danielljeon/component_library/model_3d/time_of_flight/VL53L3 MODULE ASSEMBLY.step

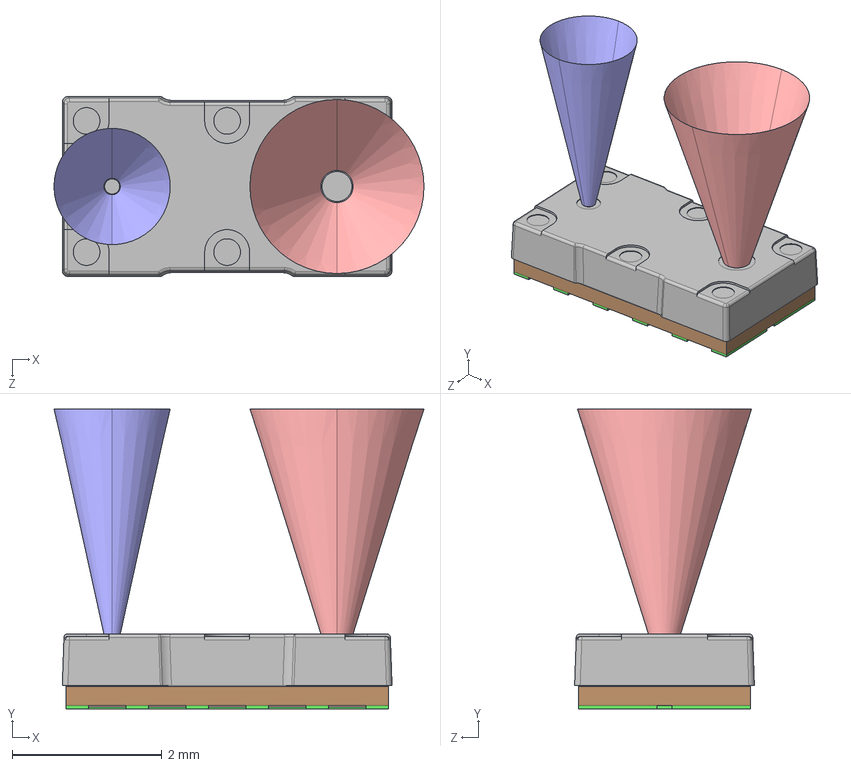
[picture p1: CAD file, 2025-02-09]
model_3d/time_of_flight/VL53L3 MODULE ASSEMBLY.step
4.94 x 4.00 x 2.40 mm
VL53L3 Substrate
VL53L3 Cap
VL53L3 Tx Exclusion Cone
VL53L3 Rx Exclusion Cone
