danielljeon/component_library/model_3d/0_standard/SOT-23-5.step

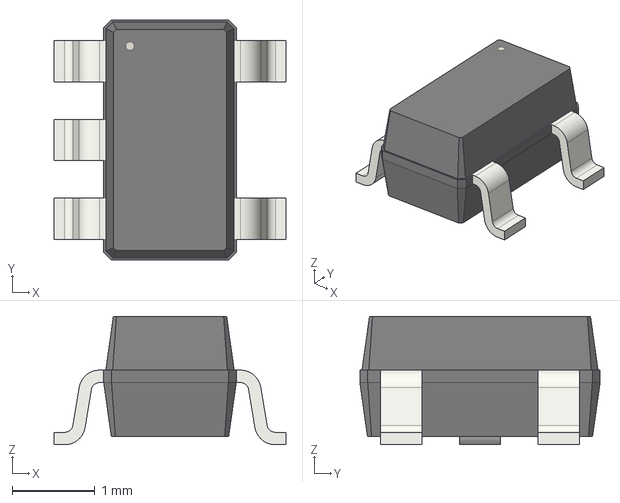
[picture p2: CAD file, 2025-07-11]
model_3d/0_standard/SOT-23-5.step
2.80 x 2.90 x 1.55 mm
