danielljeon/component_library/model_3d/bosch/BMP581.step

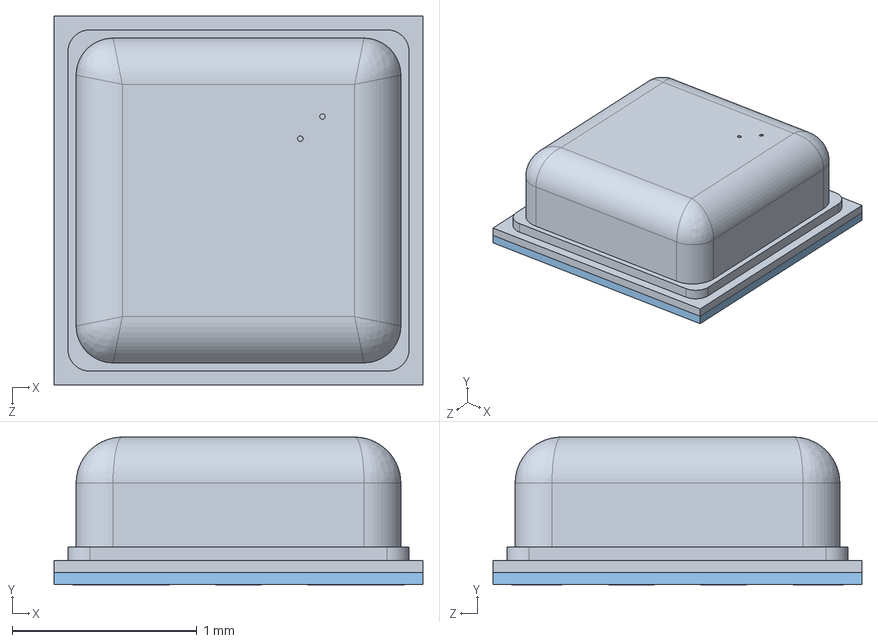
[picture p4: CAD file, 2024-11-15]
model_3d/bosch/BMP581.step
2.00 x 0.801 x 2.00 mm
