danielljeon/component_library/model_3d/ceva/BNO085.stp

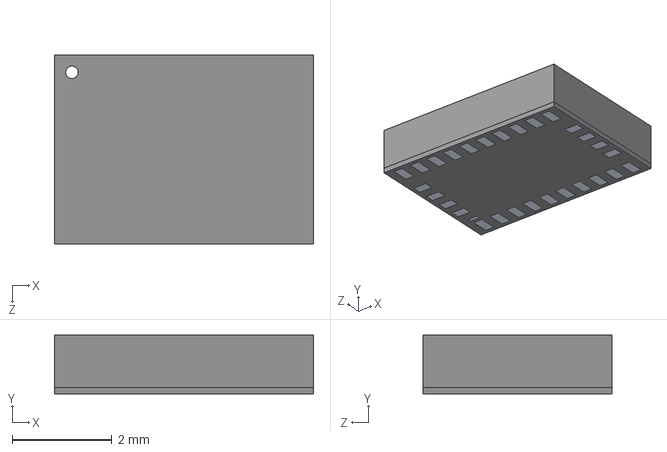
[picture p5: CAD file, 2024-11-15]
model_3d/ceva/BNO085.stp
5.20 x 1.18 x 3.80 mm
