danielljeon/component_library/model_3d/common/ecs_ecx-53r.STEP

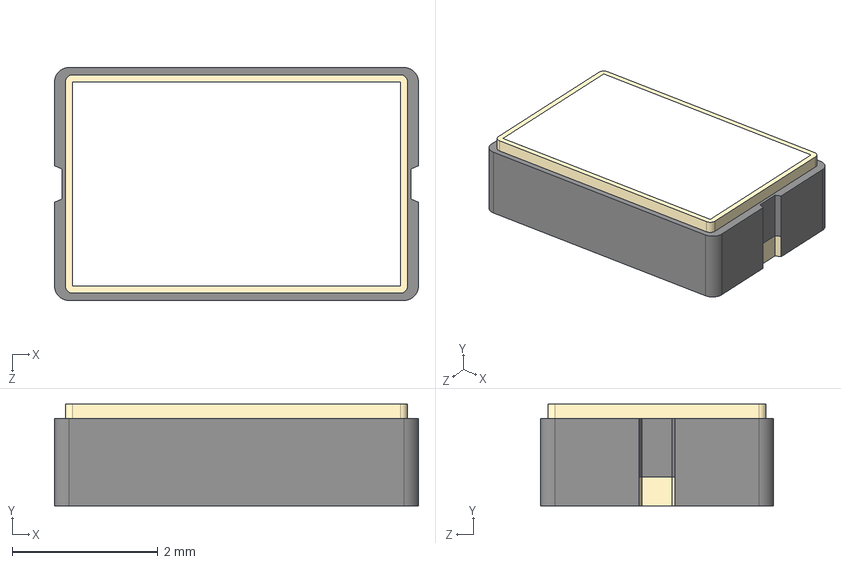
[picture p6: CAD file, 2026-04-29]
model_3d/common/ecs_ecx-53r.STEP
5.00 x 1.40 x 3.20 mm
