danielljeon/component_library/model_3d/digi_xbee/c-1-2314876-0-a-3d.stp

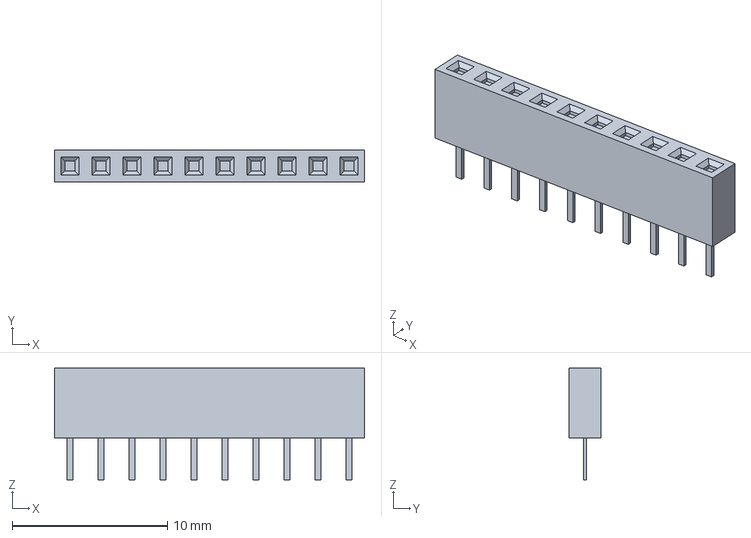
[picture p7: CAD file, 2024-11-12]
model_3d/digi_xbee/c-1-2314876-0-a-3d.stp
20.0 x 2.06 x 7.20 mm
