danielljeon/component_library/model_3d/inductors/SRN6045TA.STEP

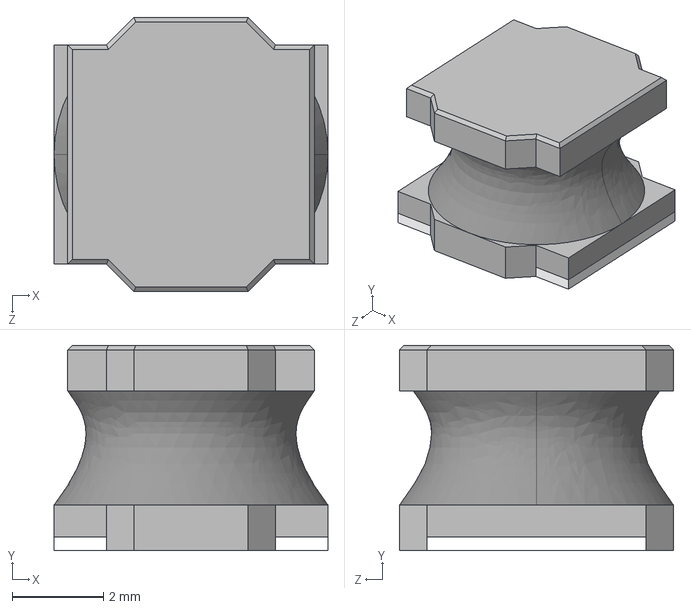
[picture p9: CAD file, 2026-06-09]
model_3d/inductors/SRN6045TA.STEP
6.00 x 4.50 x 6.00 mm
