danielljeon/component_library/model_3d/nxp/SOT782-1 HVSON-8.stp

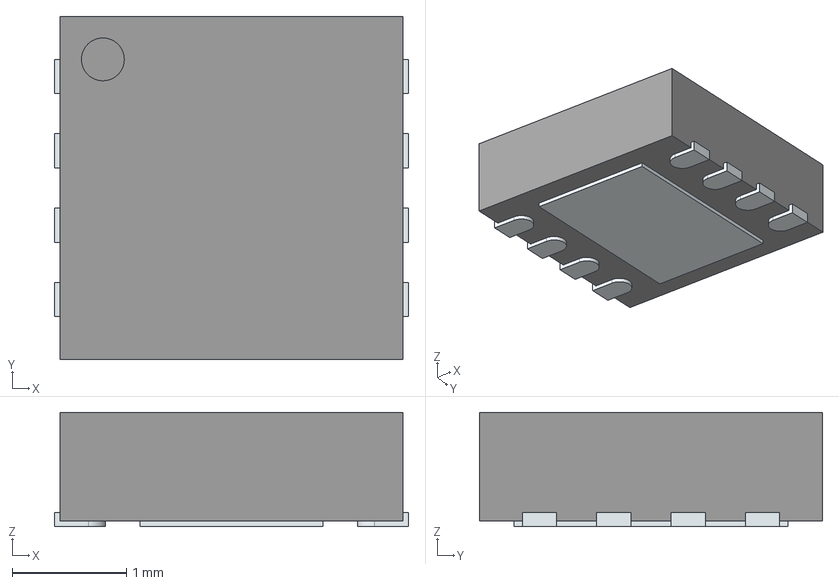
[picture p10: CAD file, 2025-05-25]
model_3d/nxp/SOT782-1 HVSON-8.stp
3.10 x 3.00 x 1.00 mm
ThermalPin
PinsArrayLR
