danielljeon/component_library/model_3d/stm32l4/QFN-32-1EP_5x5mm_P0.5mm_EP3.3x3.3mm.step

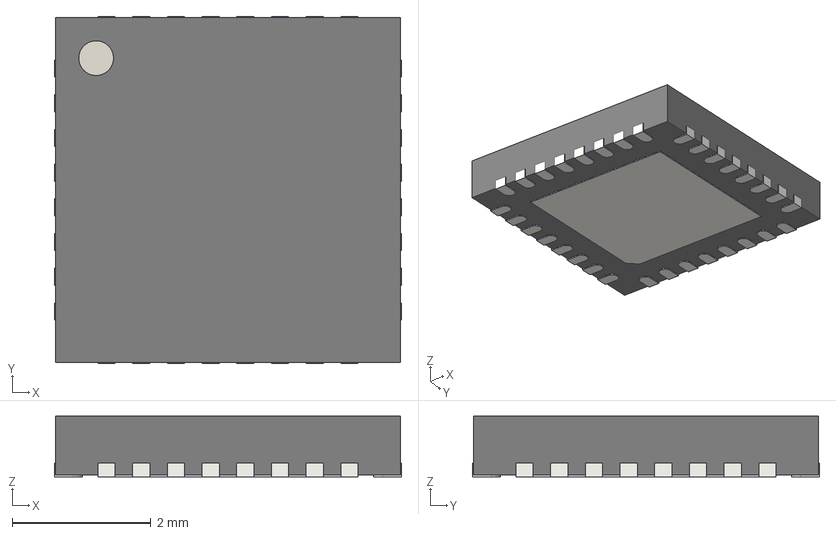
[picture p11: CAD file, 2025-01-03]
model_3d/stm32l4/QFN-32-1EP_5x5mm_P0.5mm_EP3.3x3.3mm.step
5.00 x 5.00 x 0.875 mm
