danielljeon/component_library/model_3d/stm32wb0/VFQFPN-32_STM.step

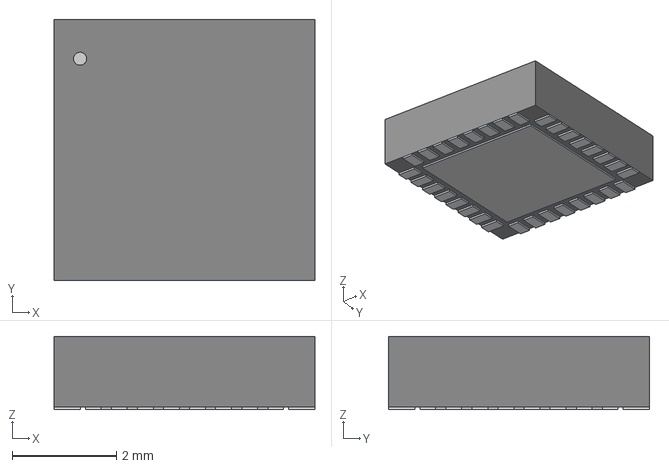
[picture p12: CAD file, 2025-01-28]
model_3d/stm32wb0/VFQFPN-32_STM.step
5.00 x 5.00 x 1.40 mm
