danielljeon/component_library/model_3d/stm32wb5/QFN-48-1EP_7x7mm_P0.5mm_EP5.15x5.15mm.step

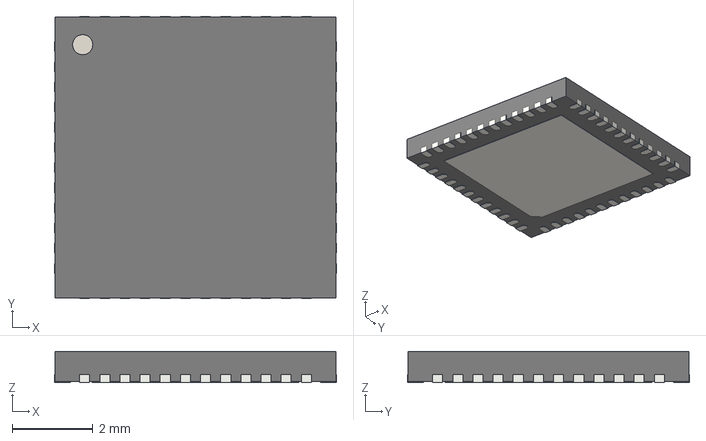
[picture p13: CAD file, 2025-04-07]
model_3d/stm32wb5/QFN-48-1EP_7x7mm_P0.5mm_EP5.15x5.15mm.step
7.00 x 7.00 x 0.77 mm
