danielljeon/component_library/model_3d/stspin32g4/QFN_IN32G4_STM.step

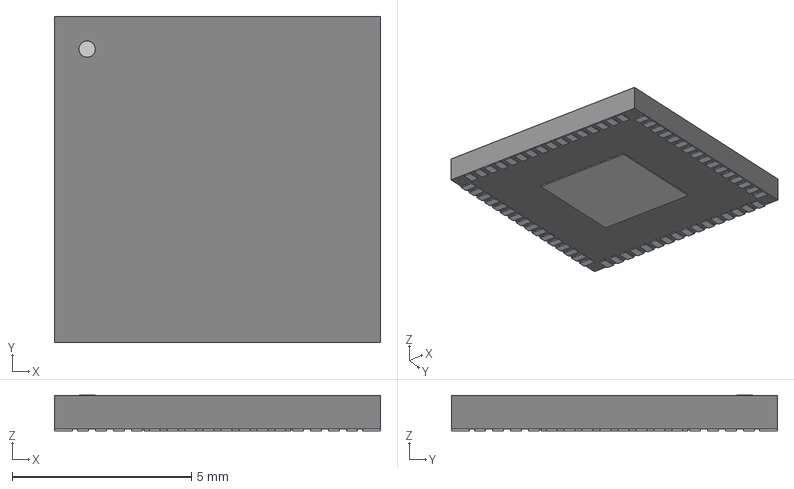
[picture p14: CAD file, 2025-07-21]
model_3d/stspin32g4/QFN_IN32G4_STM.step
9.09 x 9.09 x 0.993 mm
