danielljeon/component_library/model_3d/switch/swt0310-043025gsa.stp

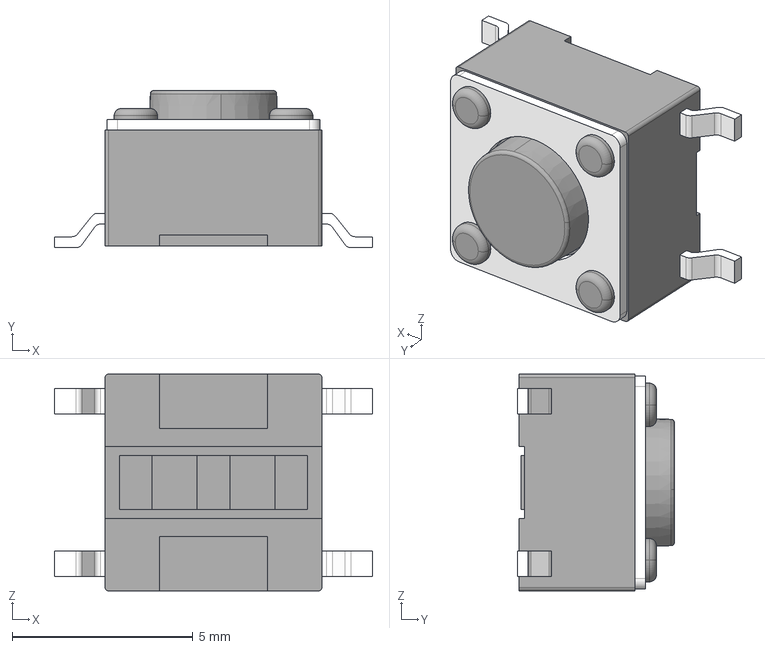
[picture p15: CAD file, 2026-06-23]
model_3d/switch/swt0310-043025gsa.stp
8.80 x 4.35 x 6.00 mm
