danielljeon/component_library/model_3d/time_of_flight/VL53L8 3D Model.step

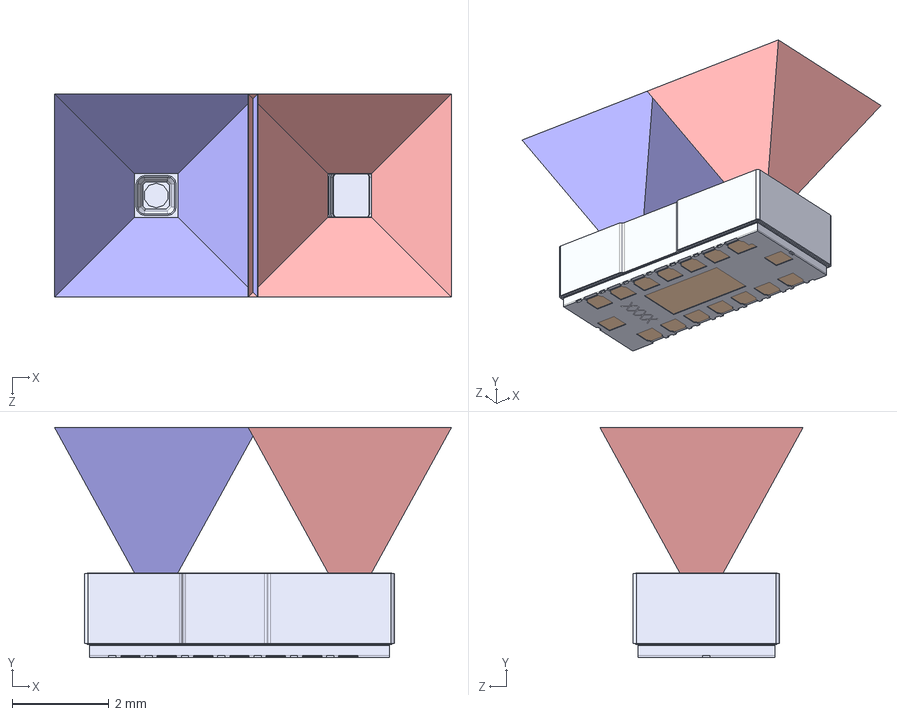
[picture p16: CAD file, 2025-09-04]
model_3d/time_of_flight/VL53L8 3D Model.step
8.20 x 4.75 x 4.20 mm
VL53L8 SUBSTRATE
VL53L8 CAP
VL53L8 Rx Exclusion Cone
VL53L8 Tx Exclusion Cone
