danielljeon/component_library/model_3d/ublox/SAM_AP214.STEP

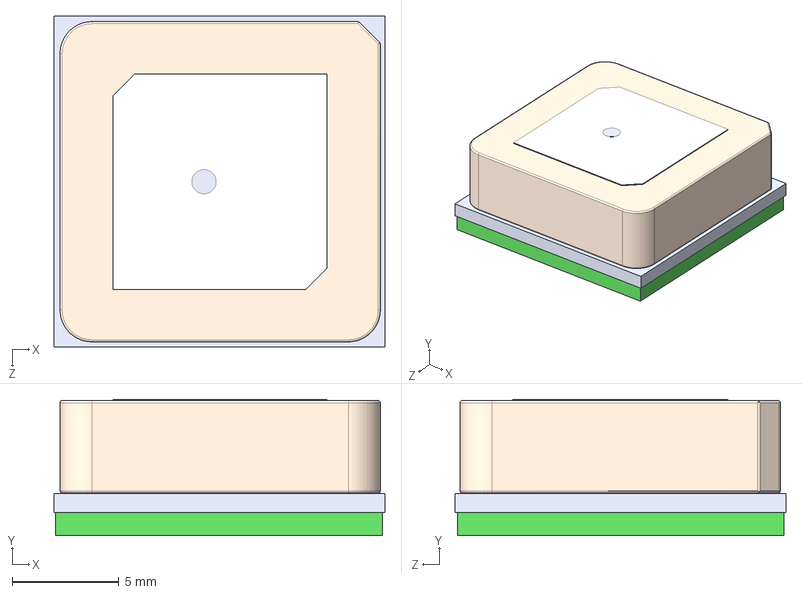
[picture p17: CAD file, 2024-10-03]
model_3d/ublox/SAM_AP214.STEP
15.5 x 6.38 x 15.5 mm
Sam cavity
SAM PCB
SAM ANT
