danielljeon/component_library/model_3d/0_standard/QFN-24-1EP_4x4mm_P0.5mm_EP2.6x2.6mm.step

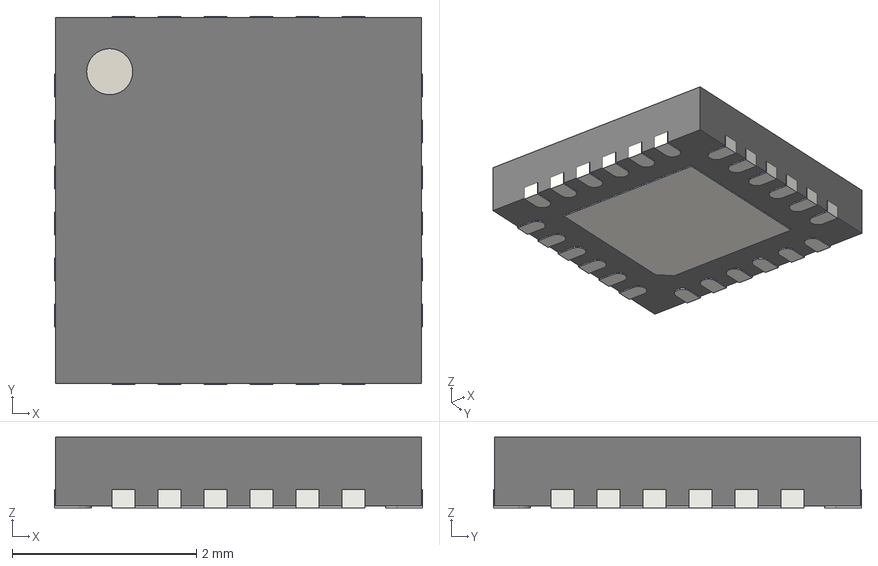
[picture p18: CAD file, 2025-07-11]
model_3d/0_standard/QFN-24-1EP_4x4mm_P0.5mm_EP2.6x2.6mm.step
4.00 x 4.00 x 0.77 mm
