danielljeon/component_library/model_3d/adafruit/5708 CAN Pal.step

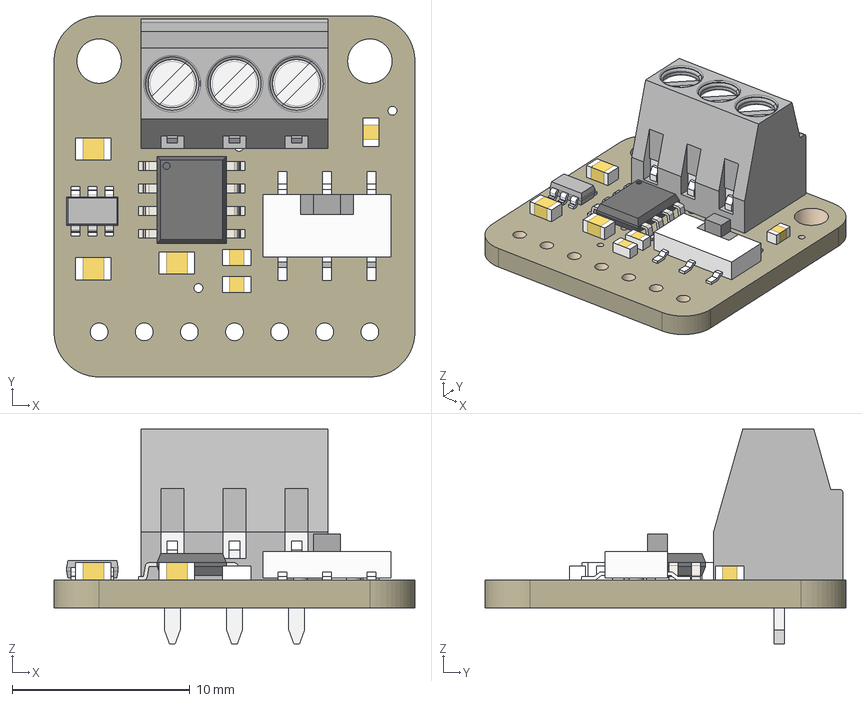
[picture p19: CAD file, 2024-11-21]
model_3d/adafruit/5708 CAN Pal.step
20.3 x 20.3 x 12.1 mm
Board
TJA1051T/3
3.5mm Terminal
10uF x 2
AP3602
1uF
60 ohm x 3
EG1390
