danielljeon/component_library/model_3d/common/TXU0304BQAR.STEP

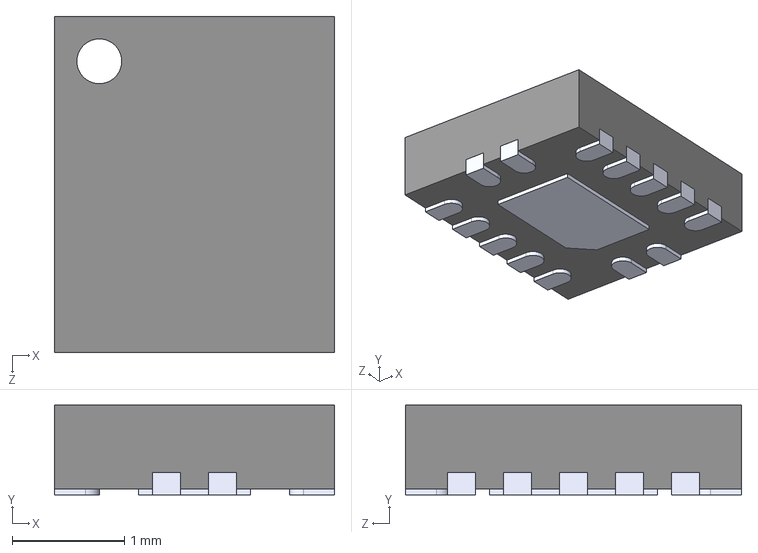
[picture p20: CAD file, 2025-09-05]
model_3d/common/TXU0304BQAR.STEP
2.50 x 0.8 x 3.00 mm
