danielljeon/component_library/model_3d/gct/BF080-20-A-1-L-C.STEP

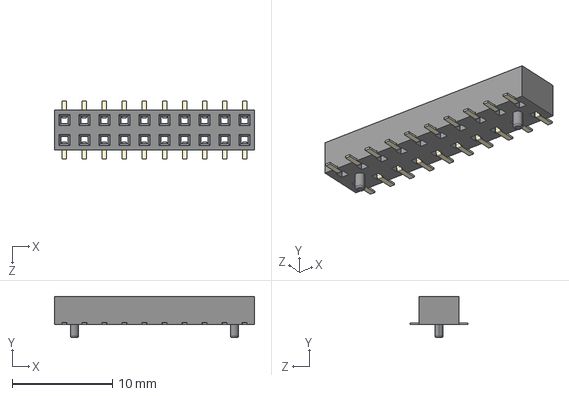
[picture p22: CAD file, 2024-12-11]
model_3d/gct/BF080-20-A-1-L-C.STEP
20.0 x 4.10 x 5.80 mm
Pin gold x 10
