danielljeon/component_library/model_3d/inductors/ASPI-6045S.STEP

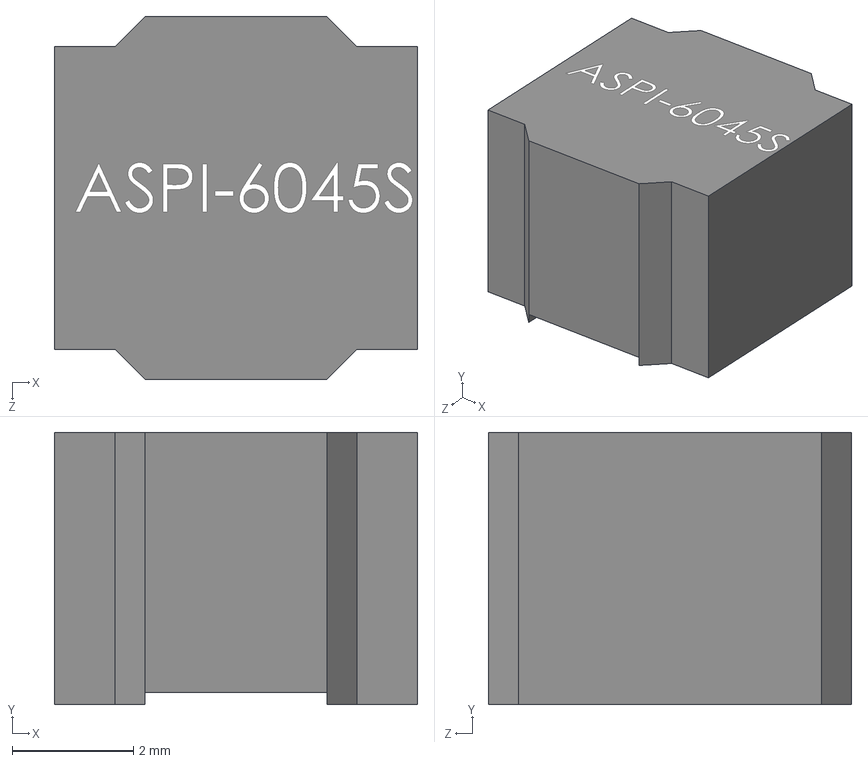
[picture p23: CAD file, 2025-09-08]
model_3d/inductors/ASPI-6045S.STEP
6.00 x 4.50 x 6.00 mm
