danielljeon/component_library/model_3d/nxp/SOT96-1 SOIC-8.stp

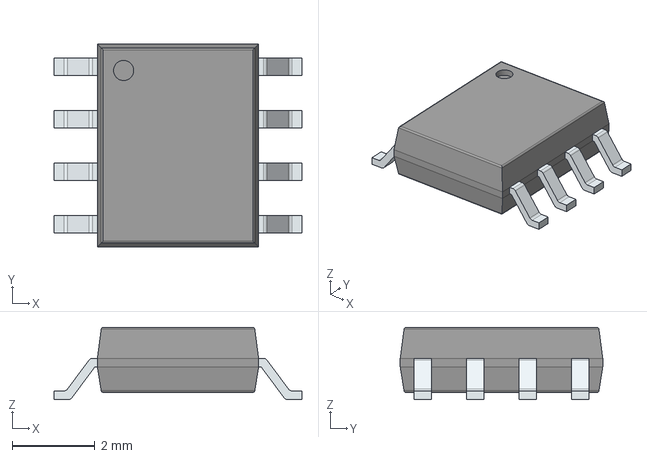
[picture p24: CAD file, 2024-11-15]
model_3d/nxp/SOT96-1 SOIC-8.stp
6.00 x 4.90 x 1.75 mm
PinsArrayLR
