danielljeon/component_library/model_3d/ti_buck/TPS56A37RPAR.STEP

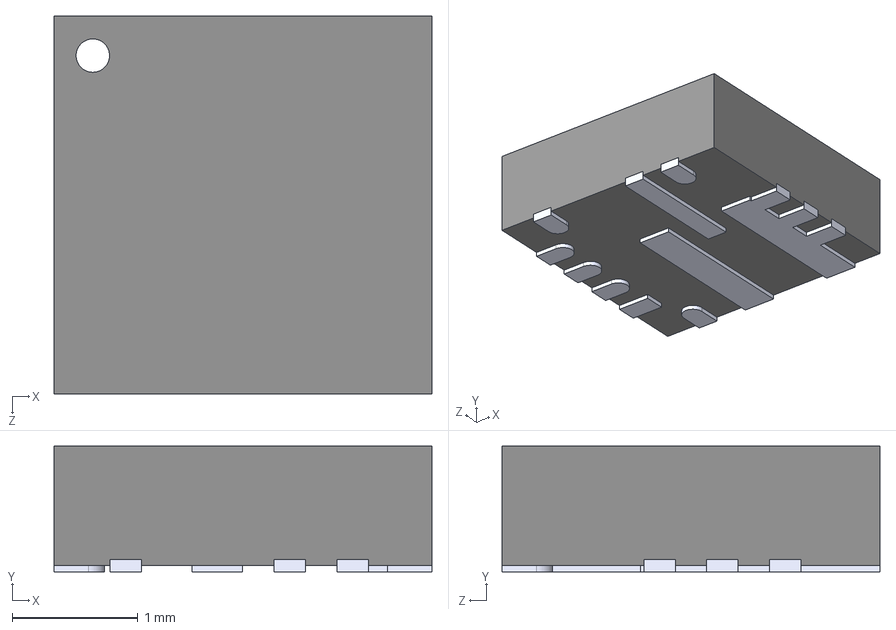
[picture p25: CAD file, 2025-09-07]
model_3d/ti_buck/TPS56A37RPAR.STEP
3.00 x 1.00 x 3.00 mm
