danielljeon/component_library/model_3d/0_standard/TQFP-32.stp

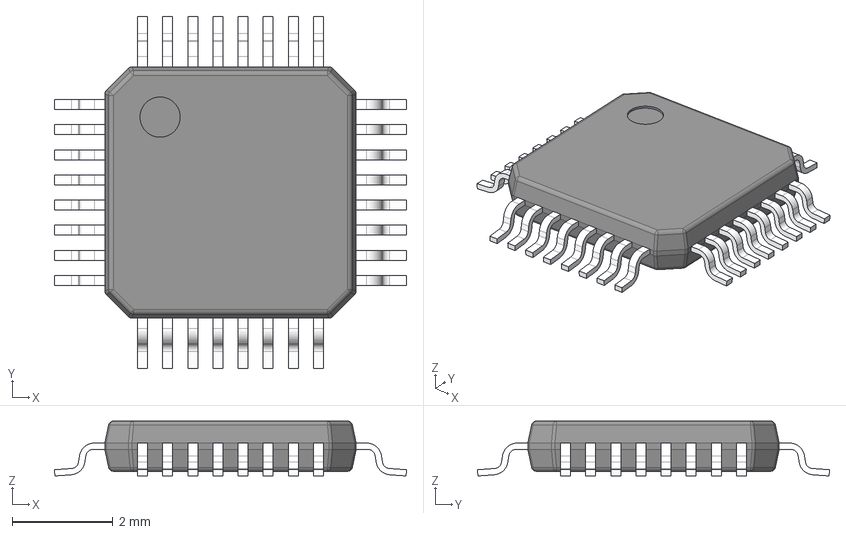
[picture p26: CAD file, 2025-02-09]
model_3d/0_standard/TQFP-32.stp
7.00 x 7.00 x 1.09 mm
BODY-TQFP
LEAD-TQFP x 32
PIN1
