danielljeon/component_library/model_3d/common/ecs_ecx-1637b.STEP

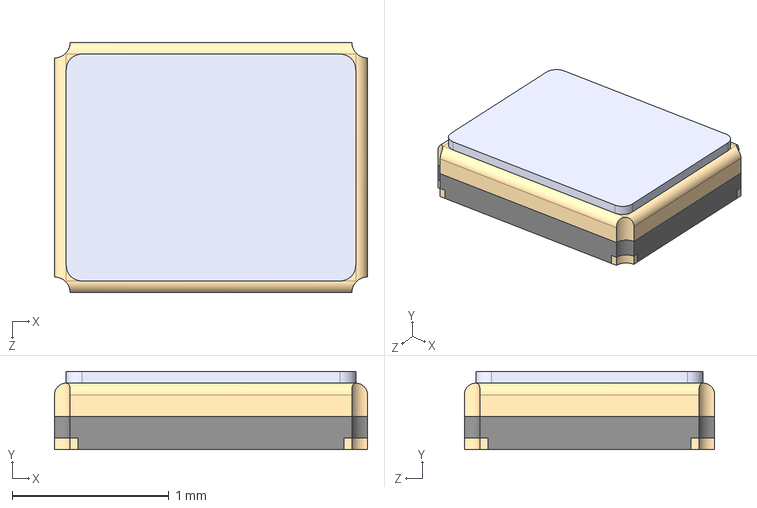
[picture p28: CAD file, 2025-08-24]
model_3d/common/ecs_ecx-1637b.STEP
2.00 x 0.5 x 1.60 mm
