danielljeon/component_library/model_3d/ti_buck/TPSM843x20.step

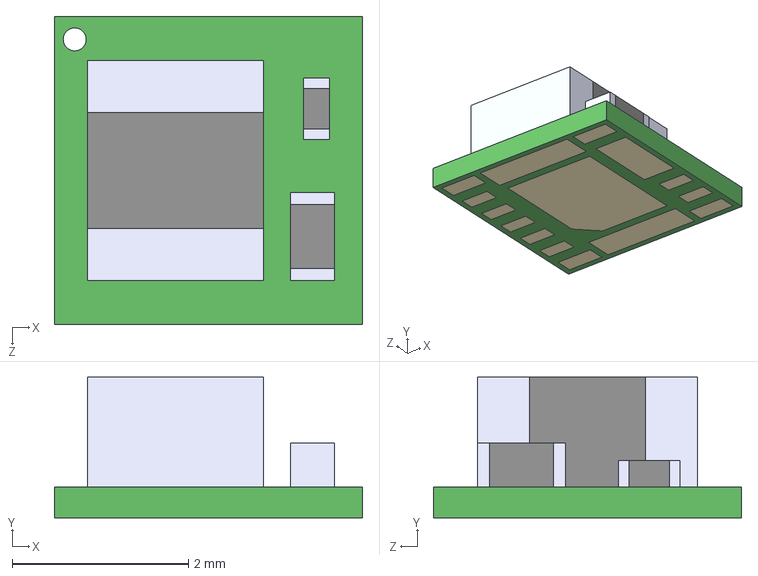
[picture p31: CAD file, 2025-01-10]
model_3d/ti_buck/TPSM843x20.step
3.50 x 1.60 x 3.50 mm
