danielljeon/component_library/model_3d/0_standard/SOT-23-THN.stp

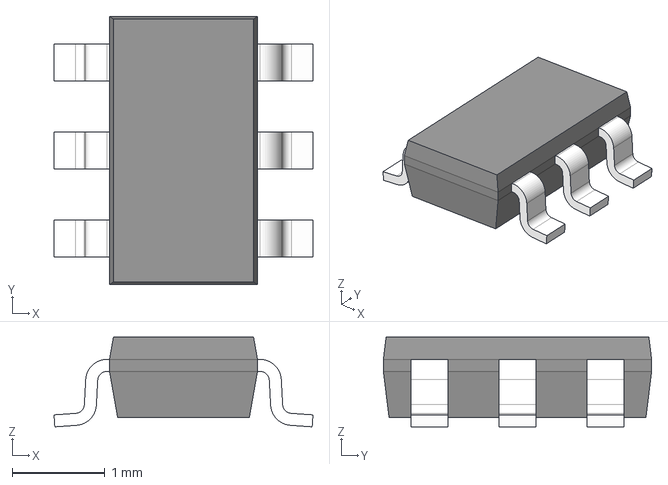
[picture p32: CAD file, 2025-01-24]
model_3d/0_standard/SOT-23-THN.stp
2.80 x 2.90 x 0.97 mm
BODY-SOT
LEAD-SOT x 6
