danielljeon/component_library/model_3d/ti_buck/TPSM8290x.step

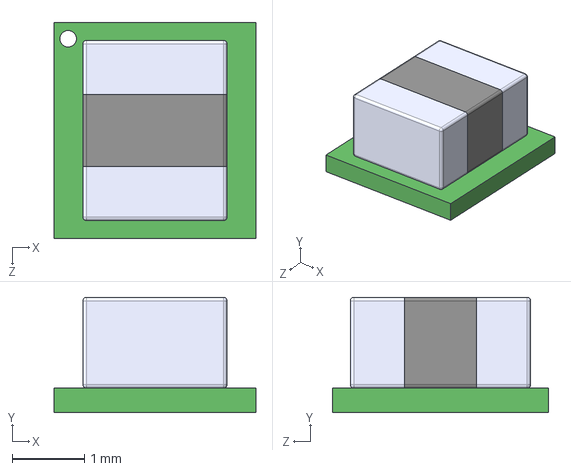
[picture p35: CAD file, 2025-01-06]
model_3d/ti_buck/TPSM8290x.step
2.80 x 1.60 x 3.00 mm
