danielljeon/component_library/model_3d/common/TXB0106RGYR.STEP

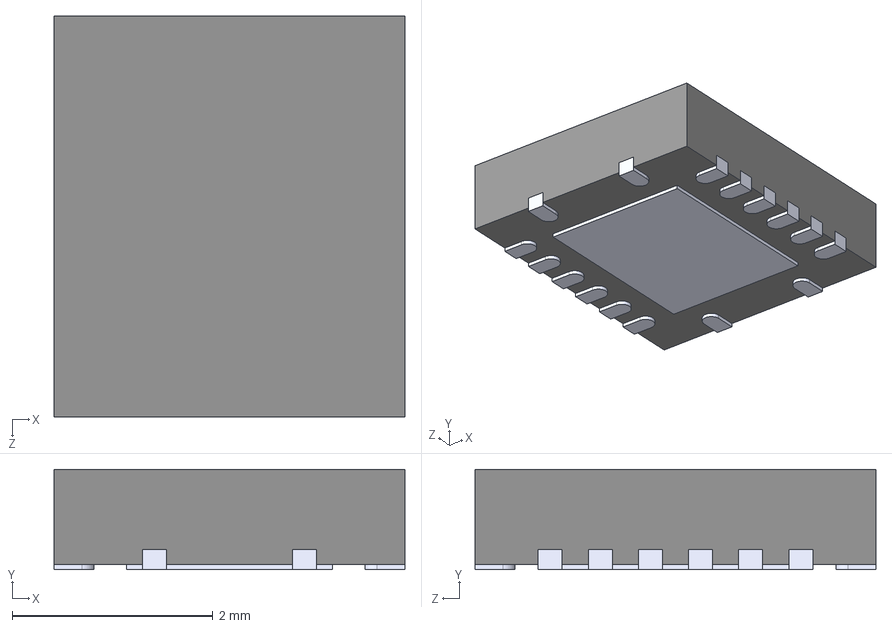
[picture p36: CAD file, 2025-05-22]
model_3d/common/TXB0106RGYR.STEP
3.50 x 1.00 x 4.00 mm
