danielljeon/component_library/model_3d/gct/BF030-16A-B1-0360-0277-0600-LB.STEP

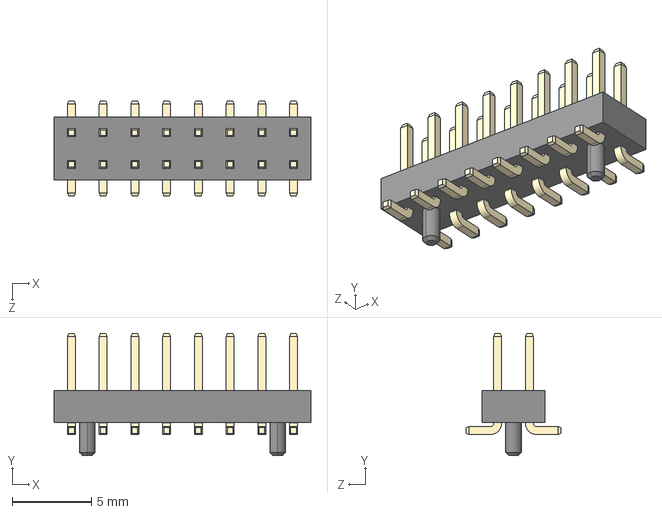
[picture p37: CAD file, 2024-12-11]
model_3d/gct/BF030-16A-B1-0360-0277-0600-LB.STEP
16.2 x 7.70 x 6.00 mm
body^BF030-xxxx_16
pin^BF030-xxxx x 8
