danielljeon/component_library/model_3d/gct/BF080-08-A-1-L-C.STEP

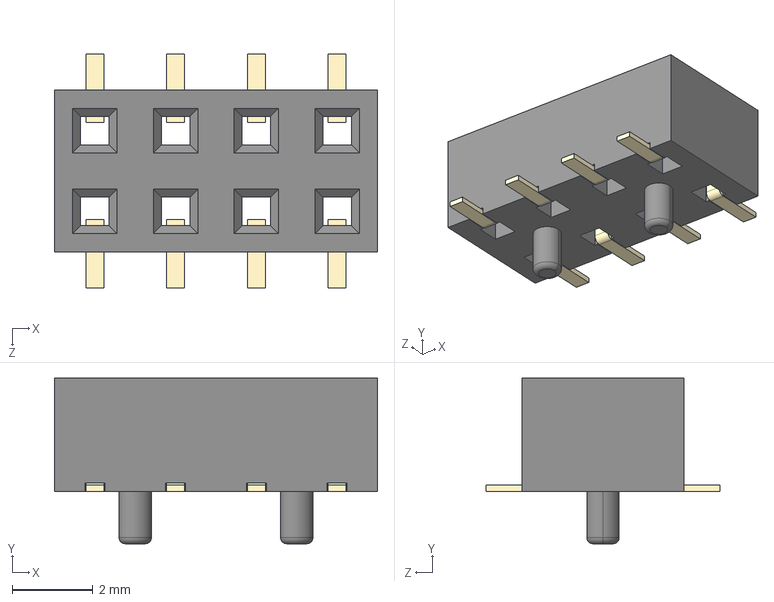
[picture p40: CAD file, 2024-12-11]
model_3d/gct/BF080-08-A-1-L-C.STEP
8.00 x 4.10 x 5.80 mm
Pin gold x 4
