danielljeon/component_library/model_3d/gct/BF080-16-A-1-L-C.STEP

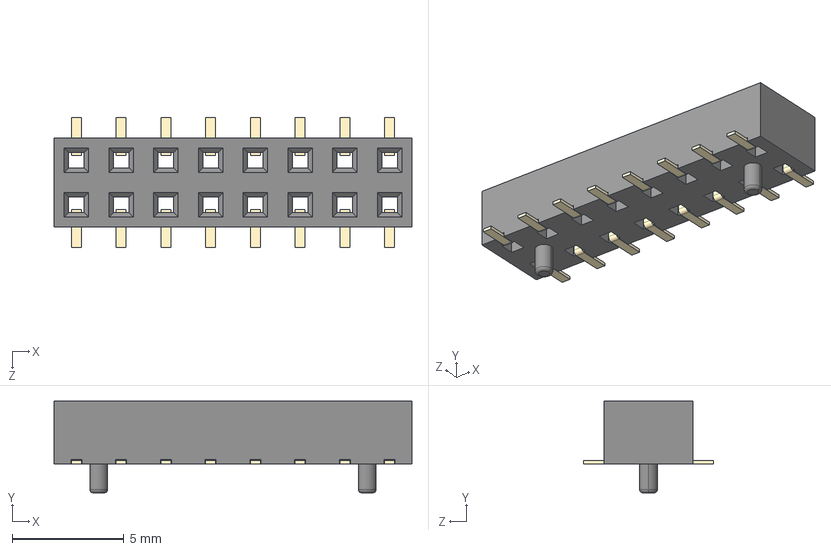
[picture p41: CAD file, 2024-12-11]
model_3d/gct/BF080-16-A-1-L-C.STEP
16.0 x 4.10 x 5.80 mm
Pin gold x 8
