danielljeon/component_library/model_3d/common/ecs_ecx-34r.step

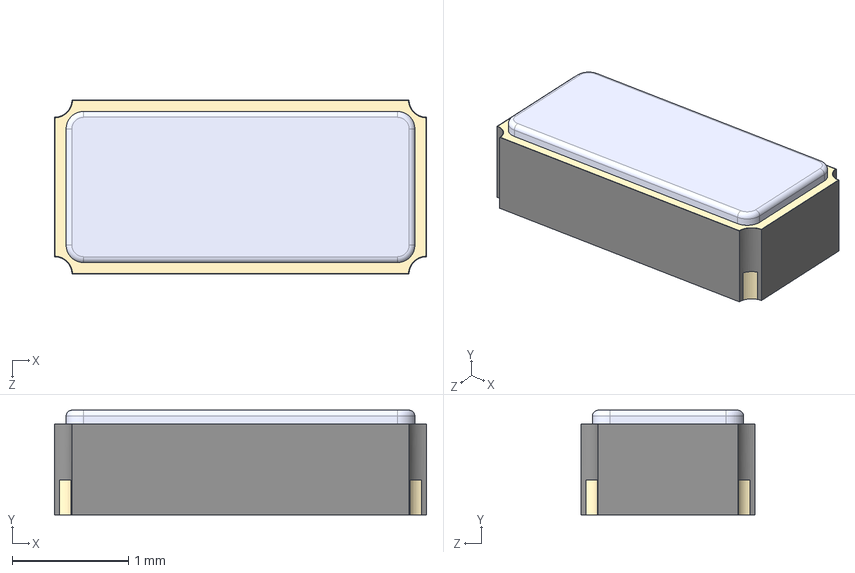
[picture p42: CAD file, 2024-12-06]
model_3d/common/ecs_ecx-34r.step
3.20 x 0.9 x 1.50 mm
