danielljeon/component_library/model_3d/common/ecs_ecx-64.step

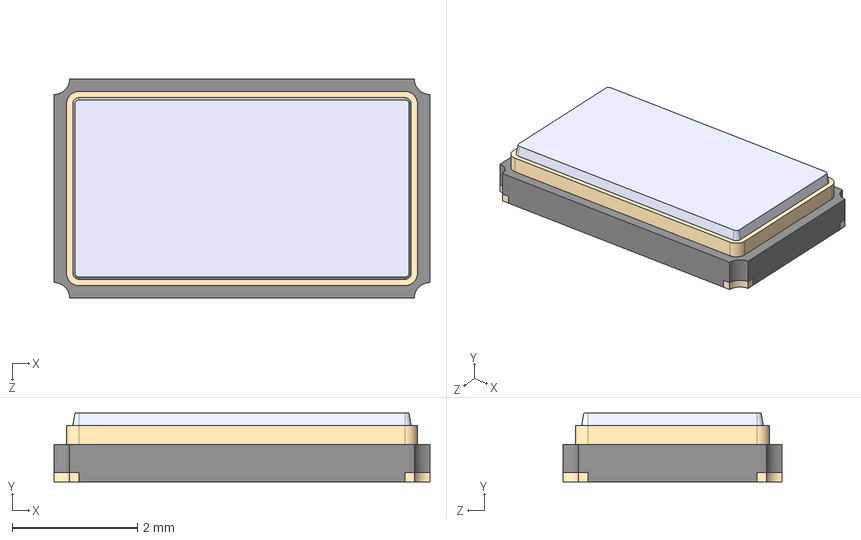
[picture p43: CAD file, 2024-12-06]
model_3d/common/ecs_ecx-64.step
6.00 x 1.10 x 3.50 mm
