danielljeon/component_library/model_3d/common/TXB0104QPWRQ1.step

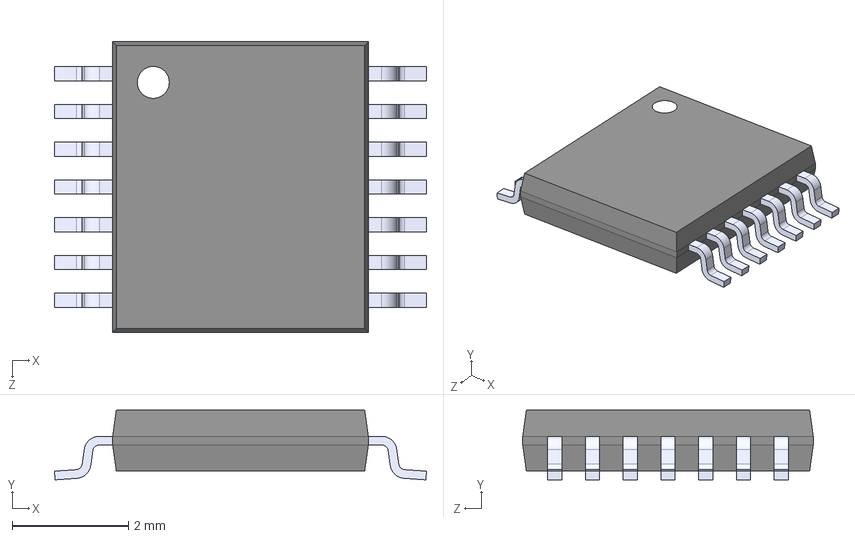
[picture p44: CAD file, 2024-10-09]
model_3d/common/TXB0104QPWRQ1.step
6.40 x 1.20 x 5.00 mm
