danielljeon/component_library/model_3d/common/TXB0106IPWRQ1.step

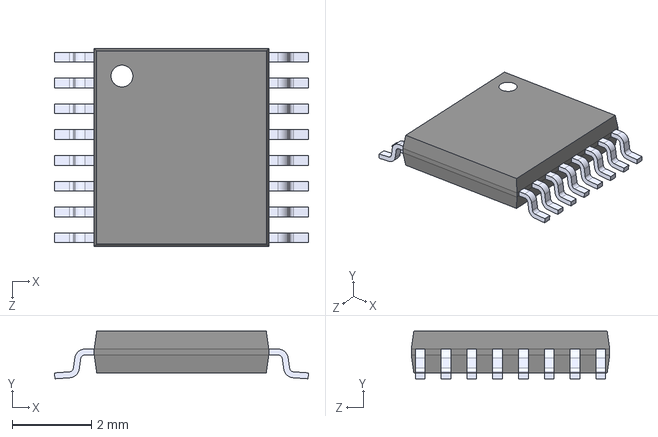
[picture p45: CAD file, 2024-10-09]
model_3d/common/TXB0106IPWRQ1.step
6.40 x 1.20 x 5.00 mm
