danielljeon/component_library/model_3d/common/S8411-45R.step

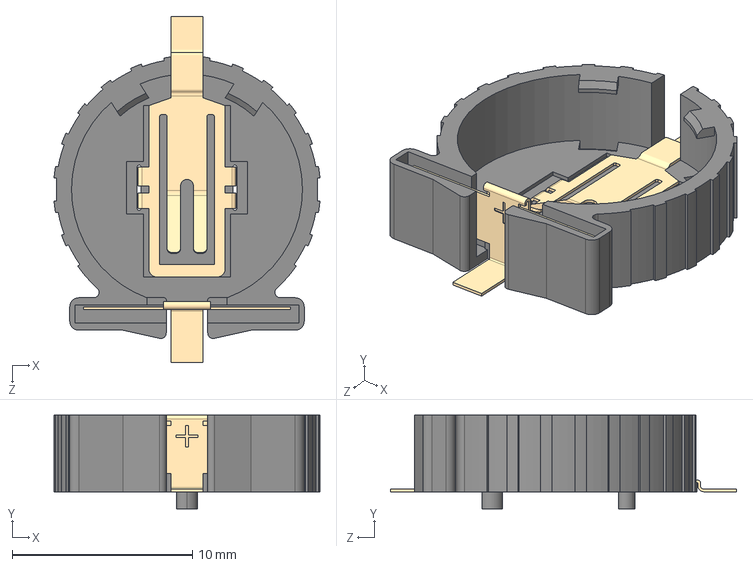
[picture p46: CAD file, 2024-10-08]
model_3d/common/S8411-45R.step
14.7 x 5.20 x 19.2 mm
