danielljeon/component_library/(list of files, cad)

Other CAD files:
model_3d/adafruit/4816 BMP390 QT.step
model_3d/common/2169900001.stp
model_3d/common/2171750001.stp
model_3d/common/2171790001.stp
model_3d/common/472192001.stp
model_3d/common/DLF162500LT-5028A1.STEP
model_3d/common/M20-9770346.step
model_3d/common/M20-9990246.step
model_3d/common/m7567-05.stp
model_3d/switch/450404015514.stp
model_3d/ti_buck/LMR51610.STEP
