danielljeon/component_library/(commit log)

2024-07-25 Add Pydantic model based PCBComponent
2024-07-27 Add template symbol and footprint
2024-07-29 Library parser (#2)
    * Add initial library parser work
    * Fix loop value error
    * Update template footprint
    * Fix minor error in validator message
    * Fix black formatting
    * Split dict formatter func
    * Add initial library parser
    * Fix param typing and setting
    * Add library parsing to main.py
    * Fix typing
    * Add API class for structured abstraction
    * Refactor rename API modules and classes
2024-09-29 Add footprint layer info
2024-09-29 Add WIP Adafruit board footprints, symbols, 3Ds
    [4682 Micro SD Breakout.step, 4754 BNO085 STEMMA QT.step, 4816 BMP390 QT.step]
2024-09-29 Add Adafruit 5708 symbol, footprint, rules check
2024-09-29 Fix courtyards and add silkscreen pin labels
2024-09-29 Add STM32F446RETx
2024-09-29 Fix Adafruit board designator REF silkscreens
2024-09-29 Include clock names on STM32F446RE symbol pins
2024-09-30 Add tag connect symbols and footprints
2024-10-02 Add Digi XBee Pro 900HP
    [XBPro-whip.STEP]
2024-10-03 Add u-blox MAX footprint and 3D model
    [SAM_AP214.STEP]
2024-10-04 Clean up symbols and footprints
2024-10-04 Add STM32 LSE crystal ABS25-32.768KHZ-6-T
    [ABS25-32.768KHZ-6-T.step]
2024-10-05 Clean up power input pins and fix footprint link
2024-10-06 Fix missing footprint link
2024-10-06 Add Molex 2171750001
    [2171750001.stp]
2024-10-06 Add 2 pin Harwin jumper components
    [M20-9990246.step, m7567-05.stp]
2024-10-08 Add S8411-45R CR1220 coin cell holder
    [S8411-45R.step]
2024-10-08 Add STM32 HSE crystal ABM3B-8.000MHZ-10-1-U-T
    [ABM3B-8.000MHZ-10-1-U-T.step]
2024-10-09 Add TXB0104QPWRQ1, TXB0106IPWRQ1 components
    [TXB0104QPWRQ1.step, TXB0106IPWRQ1.step]
2024-10-09 Add 3-position jumper and improve common jumpers
    [M20-9770346.step]
2024-10-14 Remove bad keepout zone on ublox footprint
2024-10-14 Remove bad keepout zone on jumper footprints
2024-10-14 Remove bad keepout zone on Digi footprint
2024-10-16 Fix jumper footprint properties
2024-10-16 Update courtyard and ref location for footprint
2024-10-17 Simplify CR1220 cell holder footprint
2024-10-19 Add MicroSD card holder 472192001
    [472192001.stp]
2024-10-19 Add DPAK footprints and 3D models
2024-10-21 Update 3D model for open jumper footprint
2024-11-12 Add headers for XBee PRO 900HP 3D model
    [c-1-2314876-0-a-3d.stp]
2024-11-15 Add NXP TJA1051T/3
    [SOT96-1 SOIC-8.stp]
2024-11-15 Add Bosch BMP390
    [BMP581.step]
2024-11-15 Add CEVA BNO085
    [BNO085.stp]
2024-11-21 Fix Adafruit 4816 3D model Z-axis position
2024-11-21 Add Adafruit 5708 3D model
    [5708 CAN Pal.step]
2024-12-06 Add ECS crystals
    [ecs_ecx-34r.step, ecs_ecx-64.step]
2024-12-11 Add GCT connectors for nerve
    [BF030-08A-B1-0360-0277-0600-LB.STEP, BF030-16A-B1-0360-0277-0600-LB.STEP, BF030-16A-B1-0600-0277-0600-LB.STEP, BF080-08-A-1-L-C.STEP, BF080-16-A-1-L-C.STEP]
2024-12-11 Fix pin order on GCT connector symbols
2024-12-11 Fix GCT connector symbol designators
2024-12-11 Add GCT 2mm 2x10 connectors
    [BF030-20A-B1-0360-0277-0600-LB.STEP, BF030-20A-B1-0600-0277-0600-LB.STEP, BF080-20-A-1-L-C.STEP]
2024-12-25 Add dual sided Tag-Connect footprints
2025-01-03 Add Untitled project-level footprint table
2025-01-03 Move footprint and symbol library tables
2025-01-03 Fix footprint and symbol library filepaths
2025-01-03 Clean up ublox_sam footprint
2025-01-03 Large scale footprint cleanup
2025-01-03 Add STM32L432KCU component
    [QFN-32-1EP_5x5mm_P0.5mm_EP3.3x3.3mm.step]
2025-01-06 Add TPSM8290x buck converter
    [TPSM8290x.step]
2025-01-10 Add TPSM843x20 buck converters
    [TPSM843x20.step]
2025-01-24 Add LMR51430 buck
    [SOT-23-THN.stp]
2025-01-28 Swap STM32 footprints to use STEP models
2025-01-28 Add STM32WB05KZV
    [VFQFPN-32_STM.step]
2025-01-28 Update FP and symbol tables for stm32wb0
2025-02-09 Add initial vl53l4cd_lga12 footprint
    [VL53L3 MODULE ASSEMBLY.step]
2025-02-09 Add Pin 1 marker and cleanup vl53l4cd footprint
2025-02-09 Attach footprint, complete VL53L4CD component
2025-02-09 Add initial adafruit_5396_vl53l4cd footprint
    [5396 Adafruit VL53L4CD.step]
2025-02-09 Attach footprint, complete adafruit_5396 component
2025-02-09 Add preemptive footprint table updates
2025-02-09 Attach footprint, complete ads114s08 component
    [TQFP-32.stp]
2025-02-09 Fix lmr51430 footprint pin numbers
2025-02-09 Fix pin type on ads114s08 symbol
2025-02-09 Fix adafruit_5396 pin numbers
2025-04-03 Fix silkscreen text to 0.15mm on KiCad 9.0
2025-04-03 Cleanup silkscreen and update for KiCad 9.0
2025-04-07 Add STM32WB55CGU
    [QFN-48-1EP_7x7mm_P0.5mm_EP5.15x5.15mm.step]
2025-04-07 Add stm32wb5 to fp and sym tables
2025-04-09 Add DLF162500LT-5028A1
    [DLF162500LT-5028A1.STEP]
2025-04-09 Fix inaccurate pin type on BNO085 symbol
2025-04-09 Fix to meet footprint conventions
2025-05-10 Remove outdated footprint info
2025-05-11 Tighten F courtyard
2025-05-11 Add molex_2169900001_usb_c_16p
    [2169900001.stp]
2025-05-13 Smoothen edge cut corners
2025-05-20 Add ts04-66-xx-bk-xxx-smt-xx fp
    [Same_Sky_TS04-66-55-BK-100-SMT.step]
2025-05-20 Add ecs-2520mv-080-bn
    [ECS-2520MV-080-BN-TR.step]
2025-05-20 Remove unused common crystals
    [ABM3B-8.000MHZ-10-1-U-T.step, ABS25-32.768KHZ-6-T.step]
2025-05-22 Add TXB0106RGYR
    [TXB0106RGYR.STEP]
2025-05-22 Improve ublox SAM landing pattern
2025-05-22 Cleanup bad silkscreen
2025-05-25 Remove TJA1057GT/3J due to NREC, add TJA1057BTK
    [SOT782-1 HVSON-8.stp]
2025-07-11 Add CP2102N
    [QFN-24-1EP_4x4mm_P0.5mm_EP2.6x2.6mm.step]
2025-07-11 Add TLV77133PDBVR
    [SOT-23-5.step]
2025-07-12 Cleanup USB-C footprints
2025-07-12 Add molex 2171790001, cleanup datasheet links
    [2171790001.stp]
2025-07-21 Add footprint
    [QFN_IN32G4_STM.step]
2025-07-26 Fix AS5147P pin type
2025-07-26 Cleanup AS5147P sym for sensible pin organization
2025-07-26 Change pin name for proper footprint match
2025-08-24 Add ECS-240-12-37B-CKY-TR
    [ecs_ecx-1637b.STEP]
2025-09-04 Add STM32H743ZIT6
2025-09-04 Fix minor pin type mistake
2025-09-04 Add missing standard parameters on footprint
2025-09-04 Add VL53L8CX and VL53L8CH
    [VL53L8 3D Model.step]
2025-09-04 Make N/C pin visible and passive
2025-09-05 Fix incorrect footprint info
2025-09-05 Add TXU0304BQAR
    [TXU0304BQAR.STEP]
2025-09-05 Generalize WQFN-14 footprint
2025-09-05 Remove STM32H743ZIT6
2025-09-05 Add STM32H753ZIT6
2025-09-07 Add TPS56A37RPAR
    [TPS56A37RPAR.STEP]
2025-09-08 Add inductor fp library and ASPI-6045S fp
    [ASPI-6045S.STEP]
2025-11-05 Add SPDT 450404015514 switch
    [450404015514.stp]
2026-04-27 Add STM32G431RBT6
2026-04-27 Fix STM32G431RBT6 footprint link
2026-04-29 Add ECS-80-12-30-JGN-TR
    [ecs_ecx-53r.STEP]
2026-06-09 Add LMR51610XDBVR
    [LMR51610.STEP]
2026-06-09 Add SRN6045TA-330M
    [SRN6045TA.STEP]
2026-06-09 Fix LMR51610 footprint
2026-06-23 Add swt0310-0430xxgsa footprint (switch library)
    [swt0310-043025gsa.stp]
2026-06-23 Update swt0310-0430xxgsa footprint spoke angle
